marcorispoli/PCB304/README.md

CHANGE LOG

________________________________________________________________________
01/07/2025 - Release 2 - 
Aggiornata serigrafia J11 (era rovesciata)
________________________________________________________________________
