marcorispoli/PCB304/(list of files, cad)

Other CAD files:
ESECUTIVI/PM22-304-2.dwg
LAYOUT/22-304-2.dwg
ESECUTIVI/22-304-2.dwg
ESECUTIVI/PF22-304-2.dwg
