marcorispoli/PCB304/ORCAD/SE22-304-2.pdf

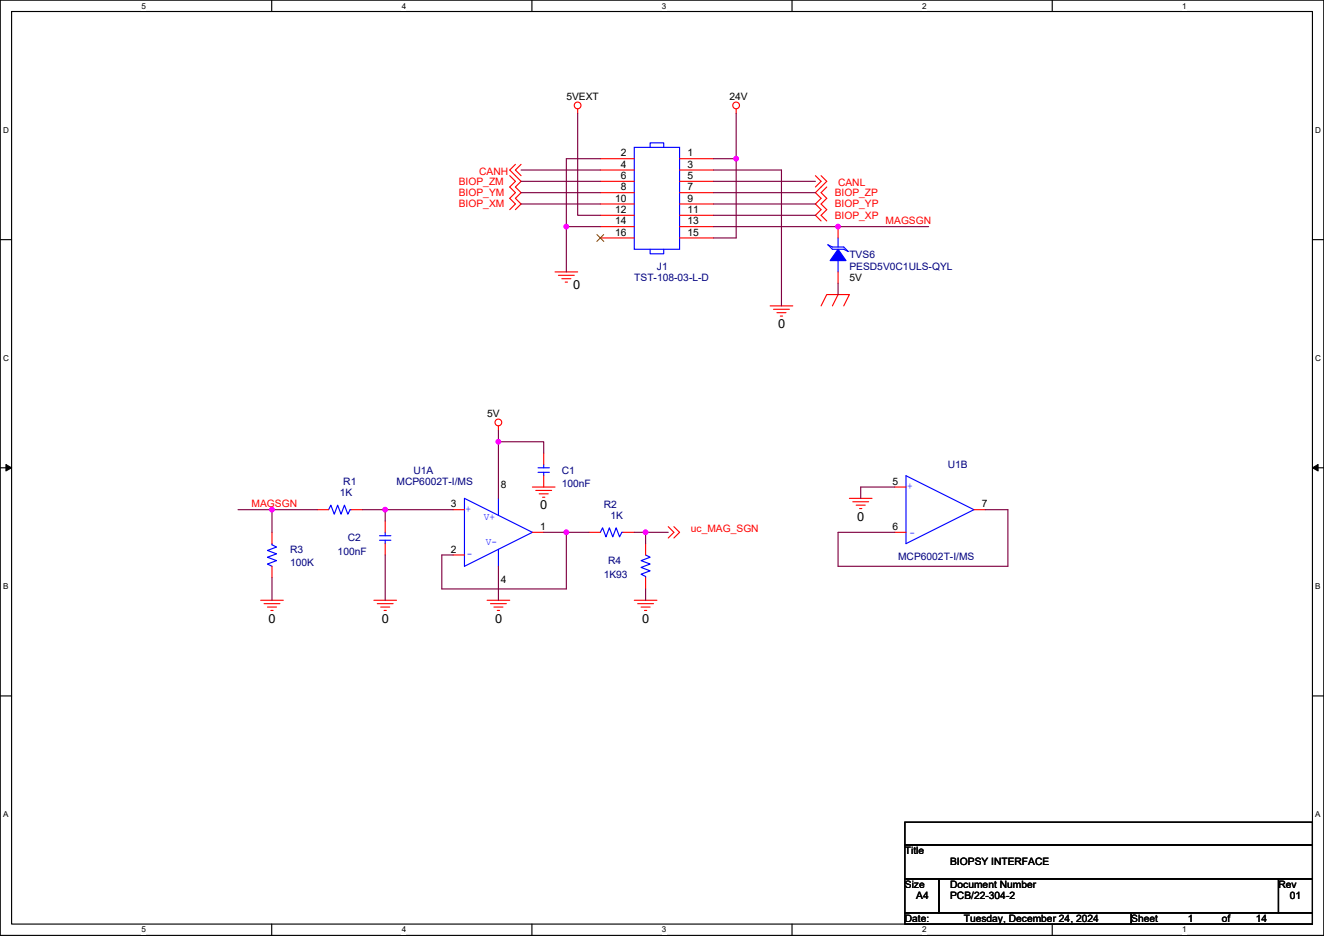
[picture p1: page 1]

Size A4 | Document Number PCB/22-304-2 | Rev 01

Date: Tuesday, December 24, 2024 Tuesday, December 24, 2024 Tuesday, December 24, 2024 | Sheet 1 1 1 of 14 14 14

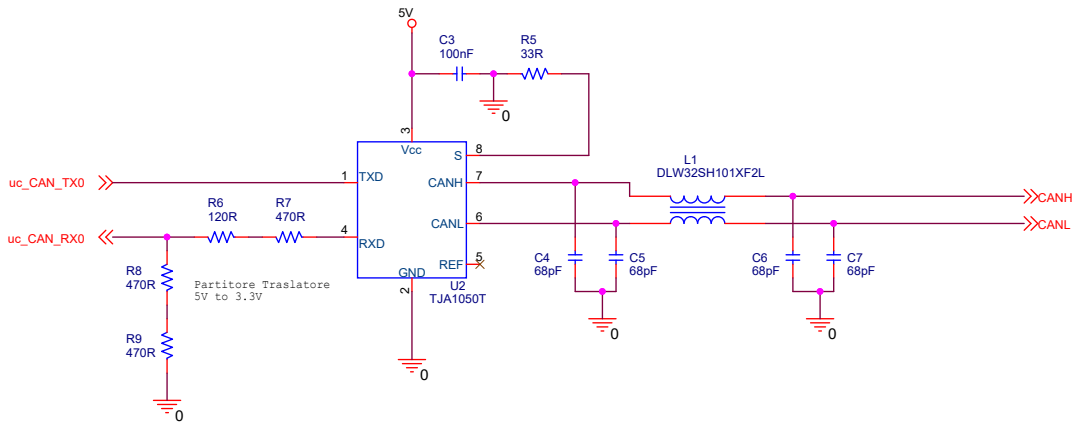
[picture p2: page 2]

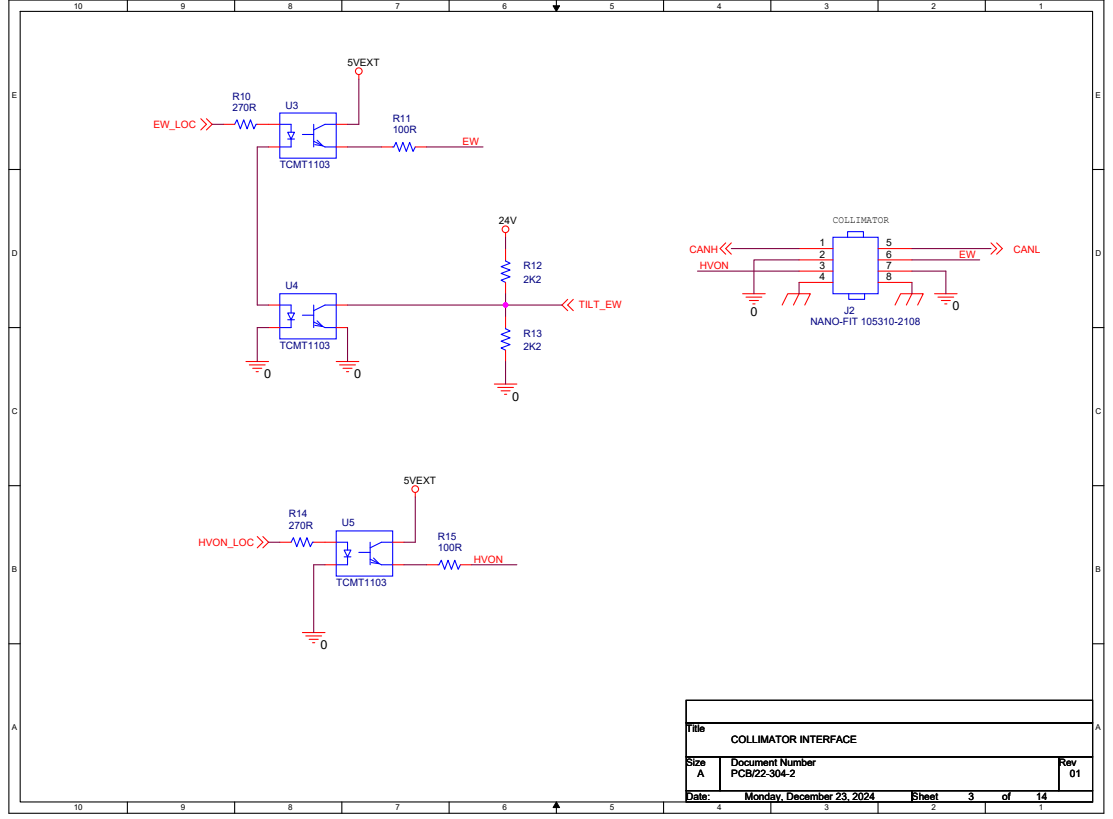
[picture p3: page 3]

Monday, December 23, 2024 Monday, December 23, 2024 Monday, December 23, 2024 | 3 3 3 14 14 14

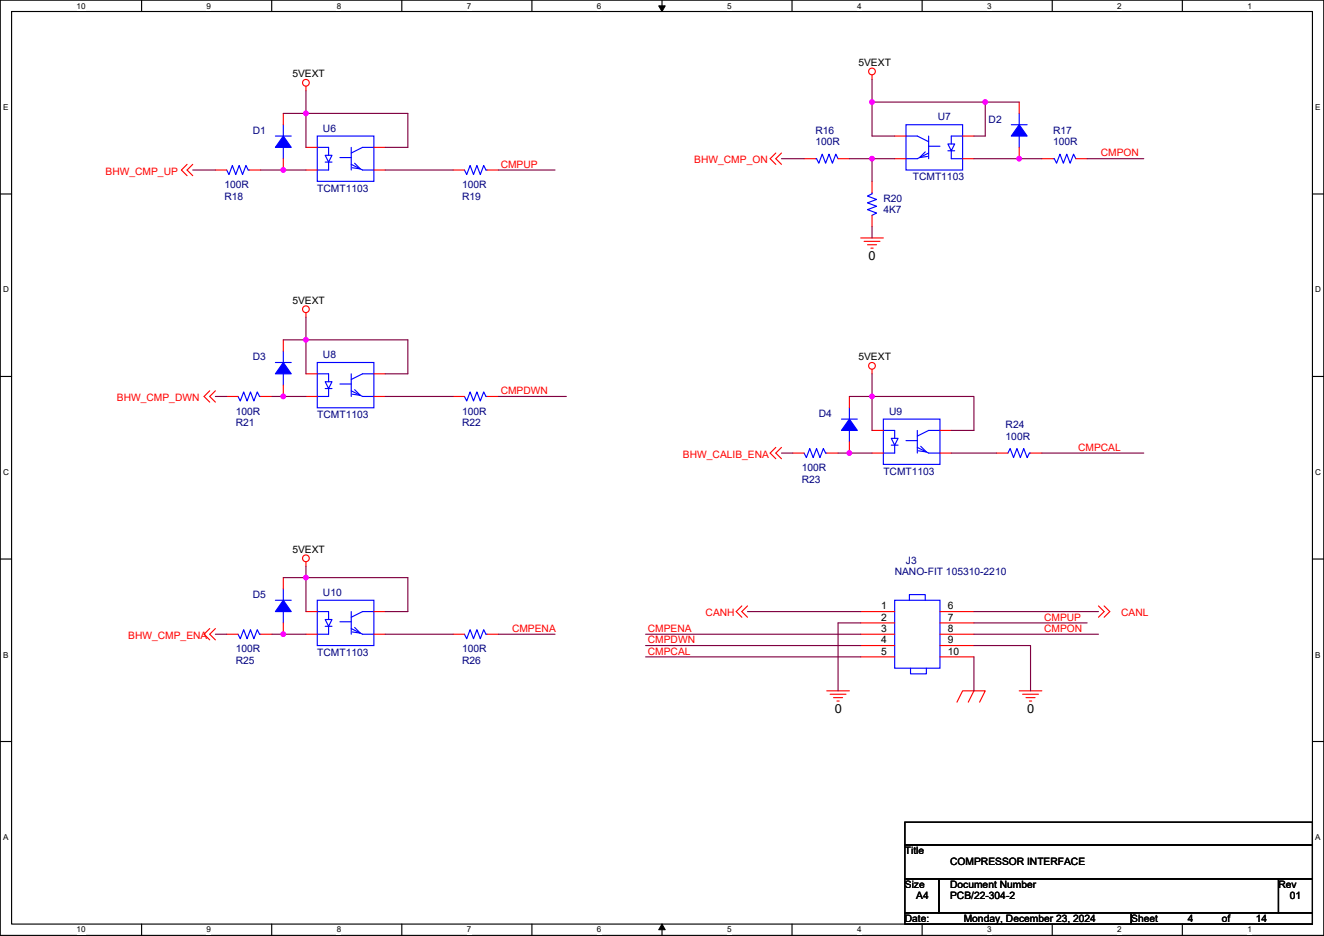
[picture p4: page 4]

0

0

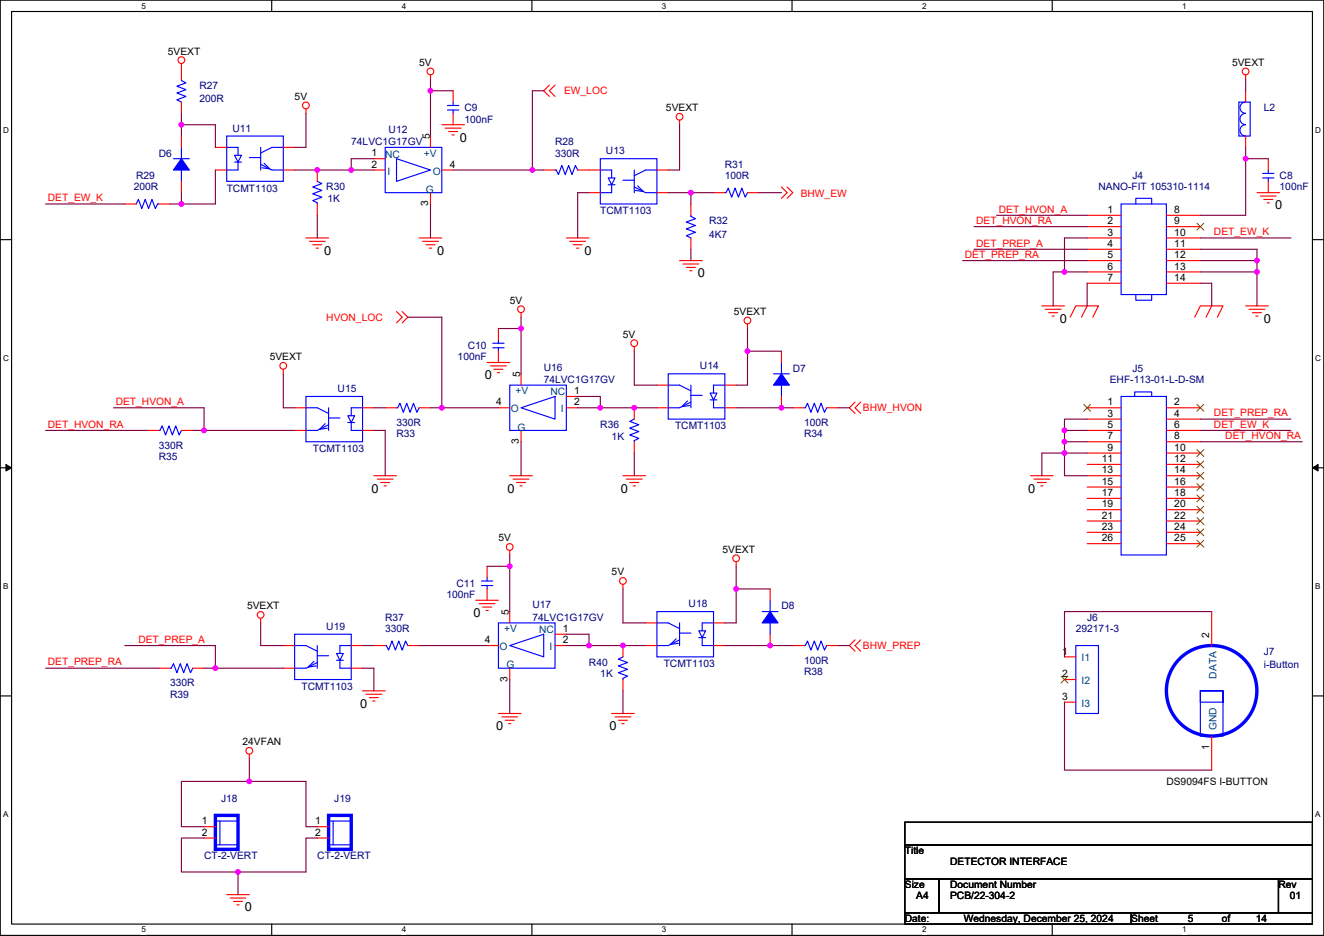
[picture p5: page 5]

0

0

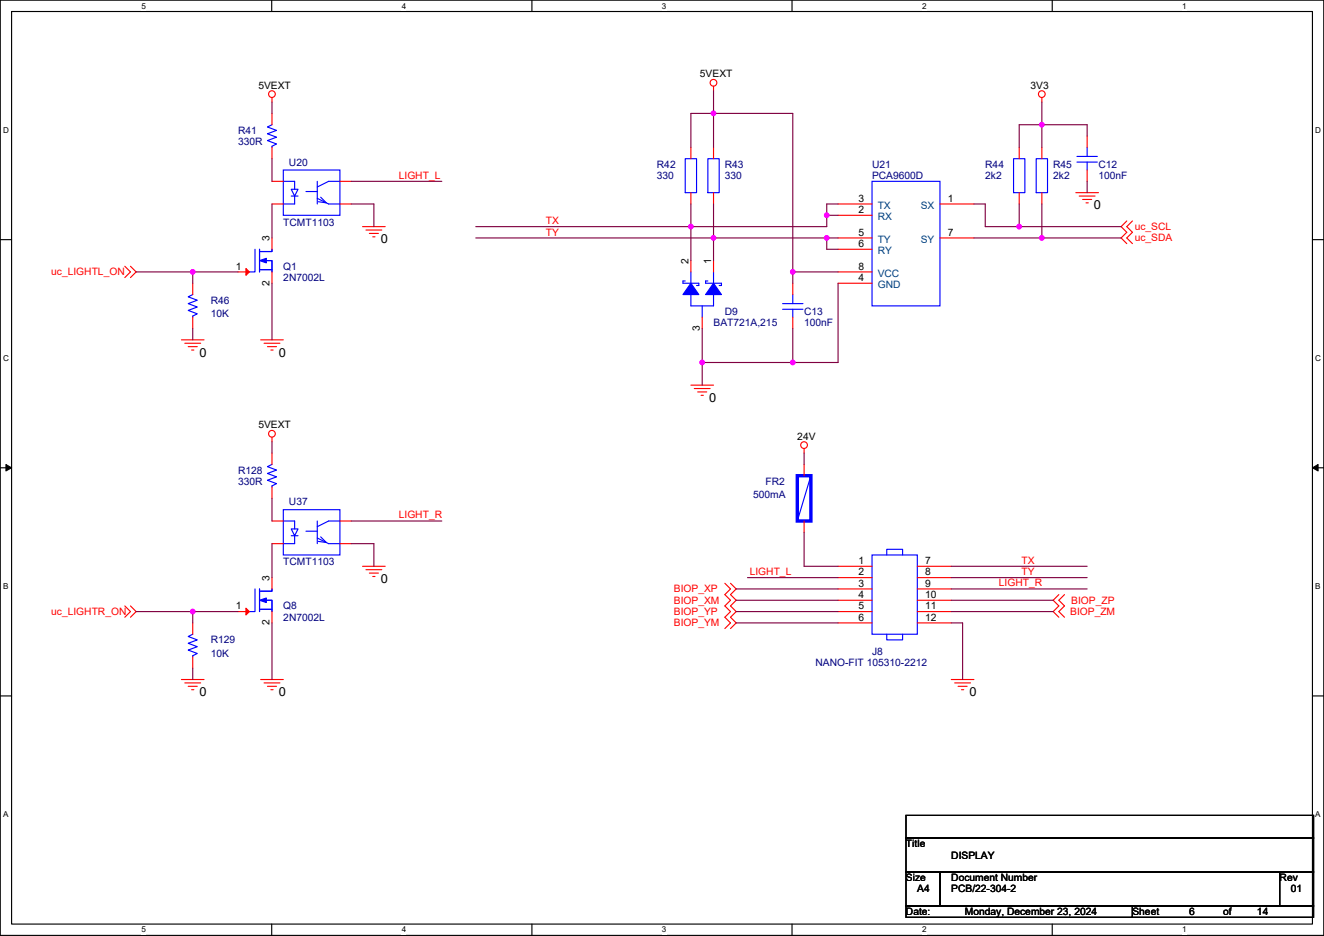
[picture p6: page 6]

0

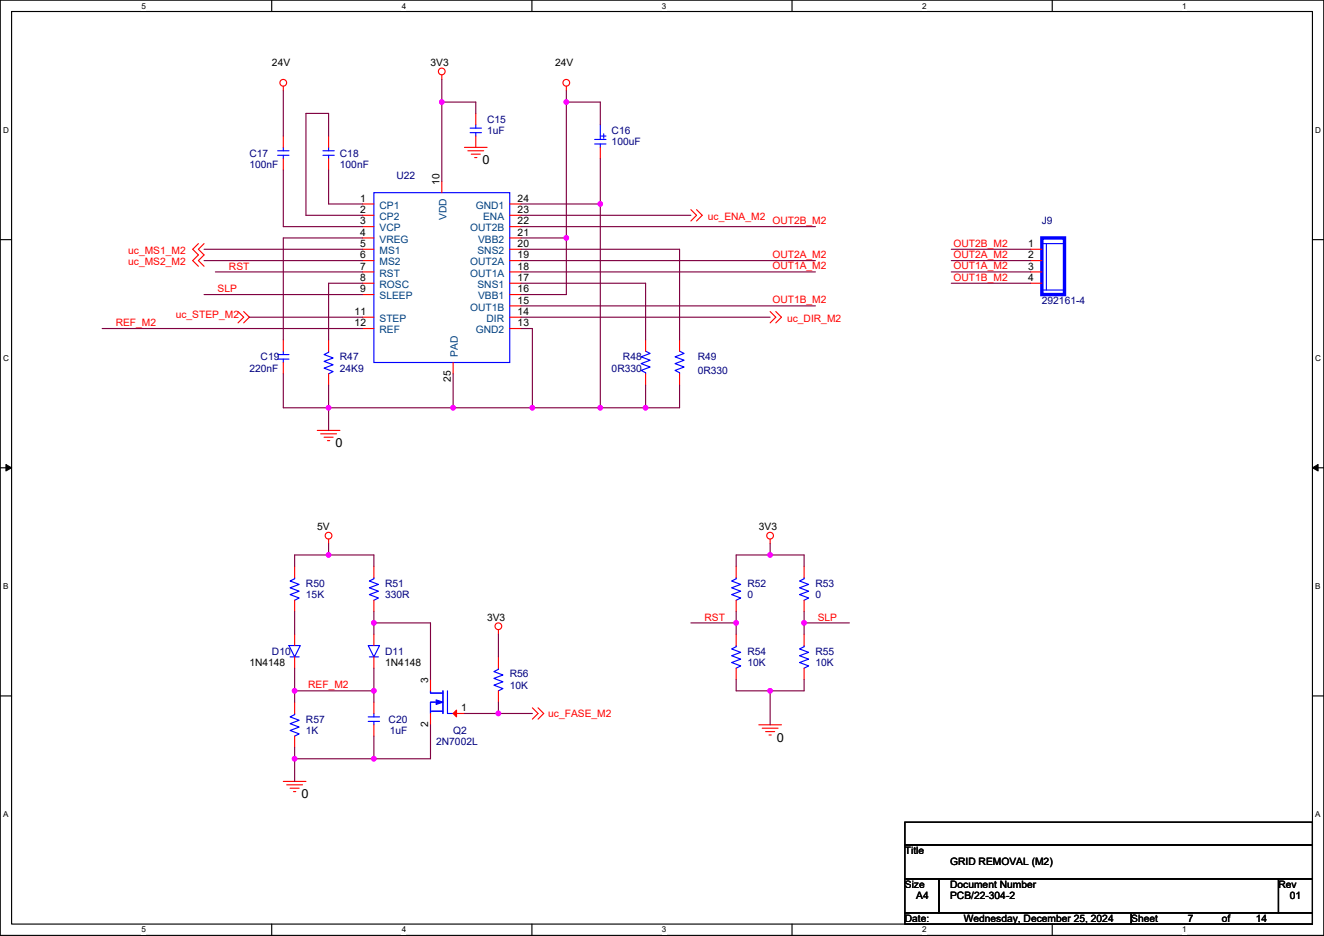
[picture p7: page 7]

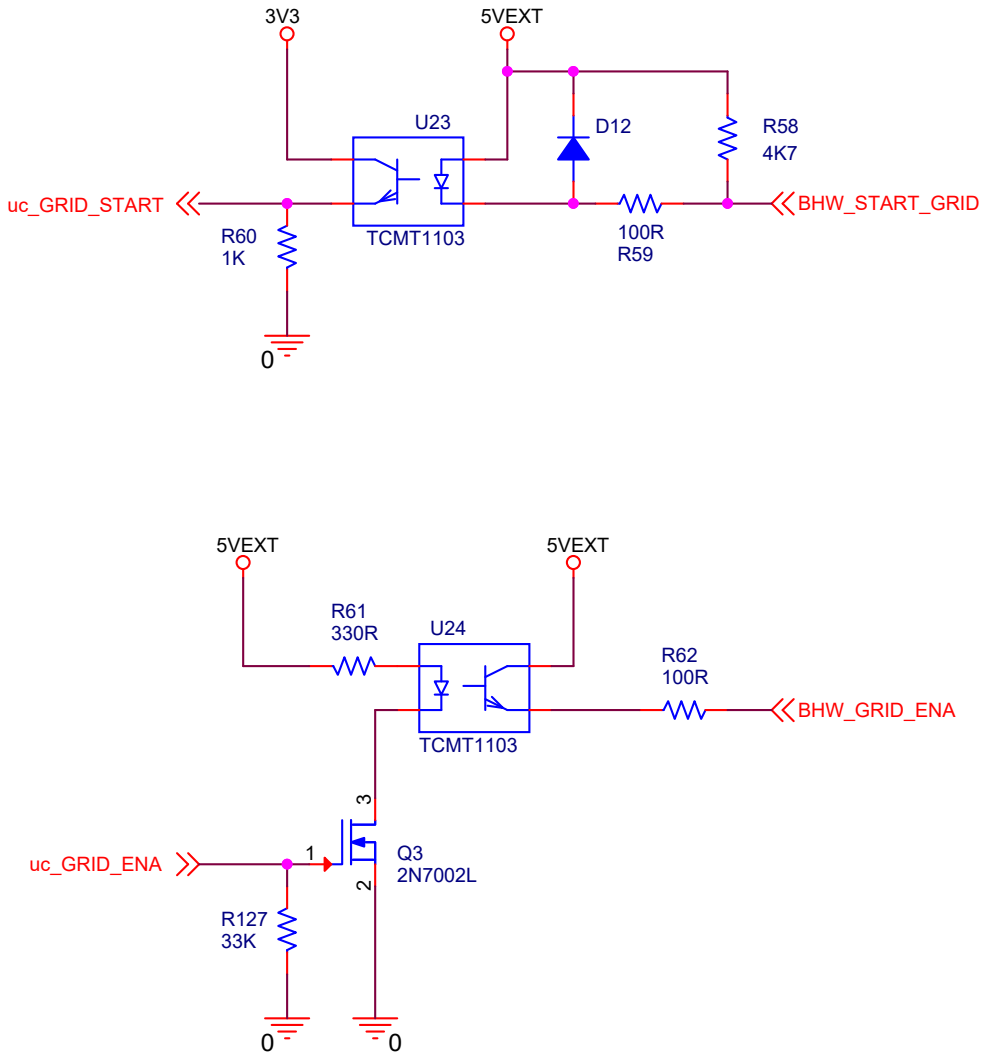
[picture p8: page 8]

Monday, December 23, 2024 Monday, December 23, 2024 Monday, December 23, 2024 | 8 8 8 14 14 14

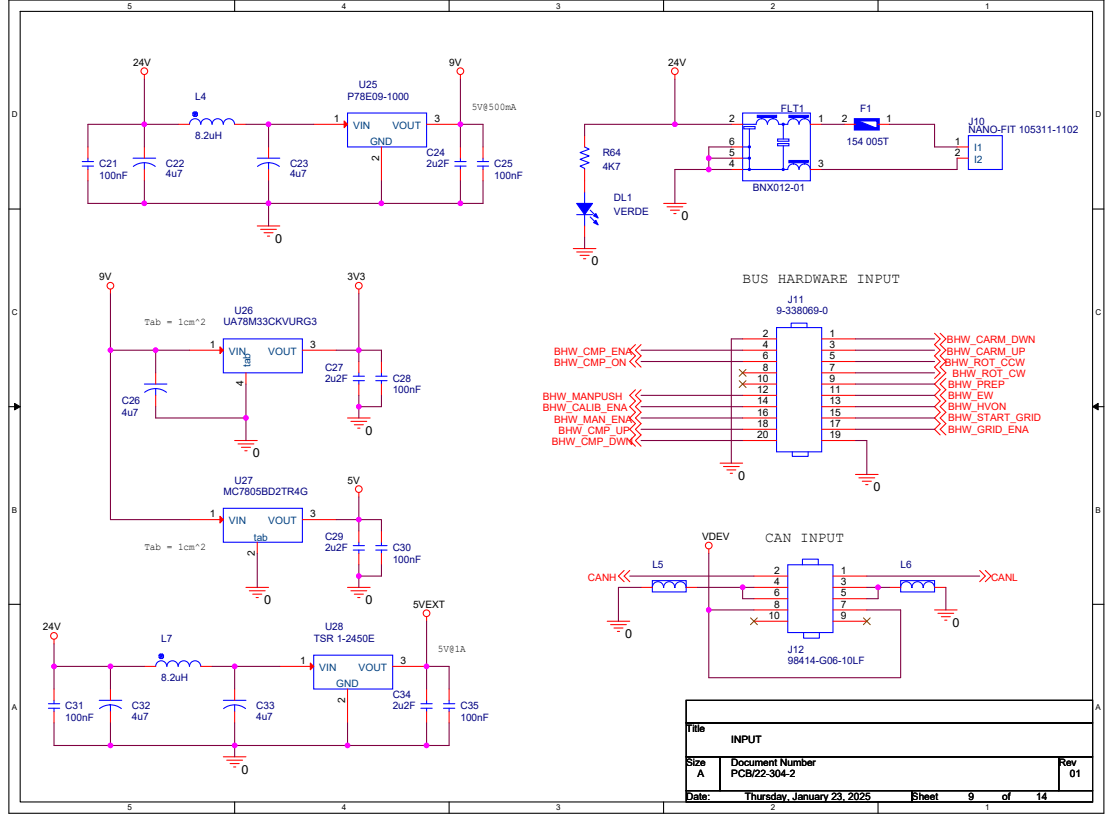
[picture p9: page 9]

Thursday, January 23, 2025 Thursday, January 23, 2025 Thursday, January 23, 2025 | 9 9 9 14 14 14

0

0

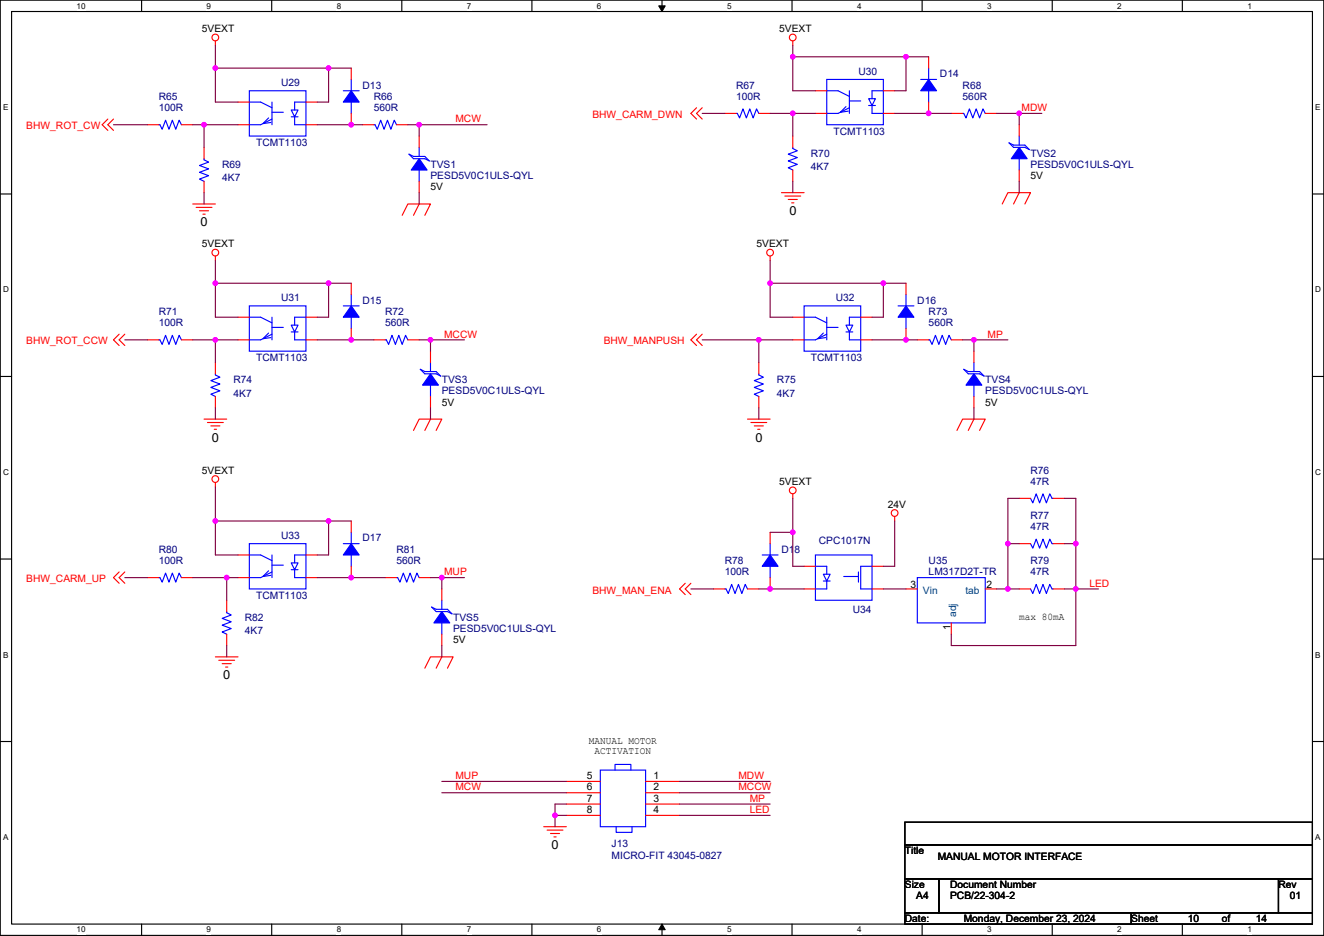
[picture p10: page 10]

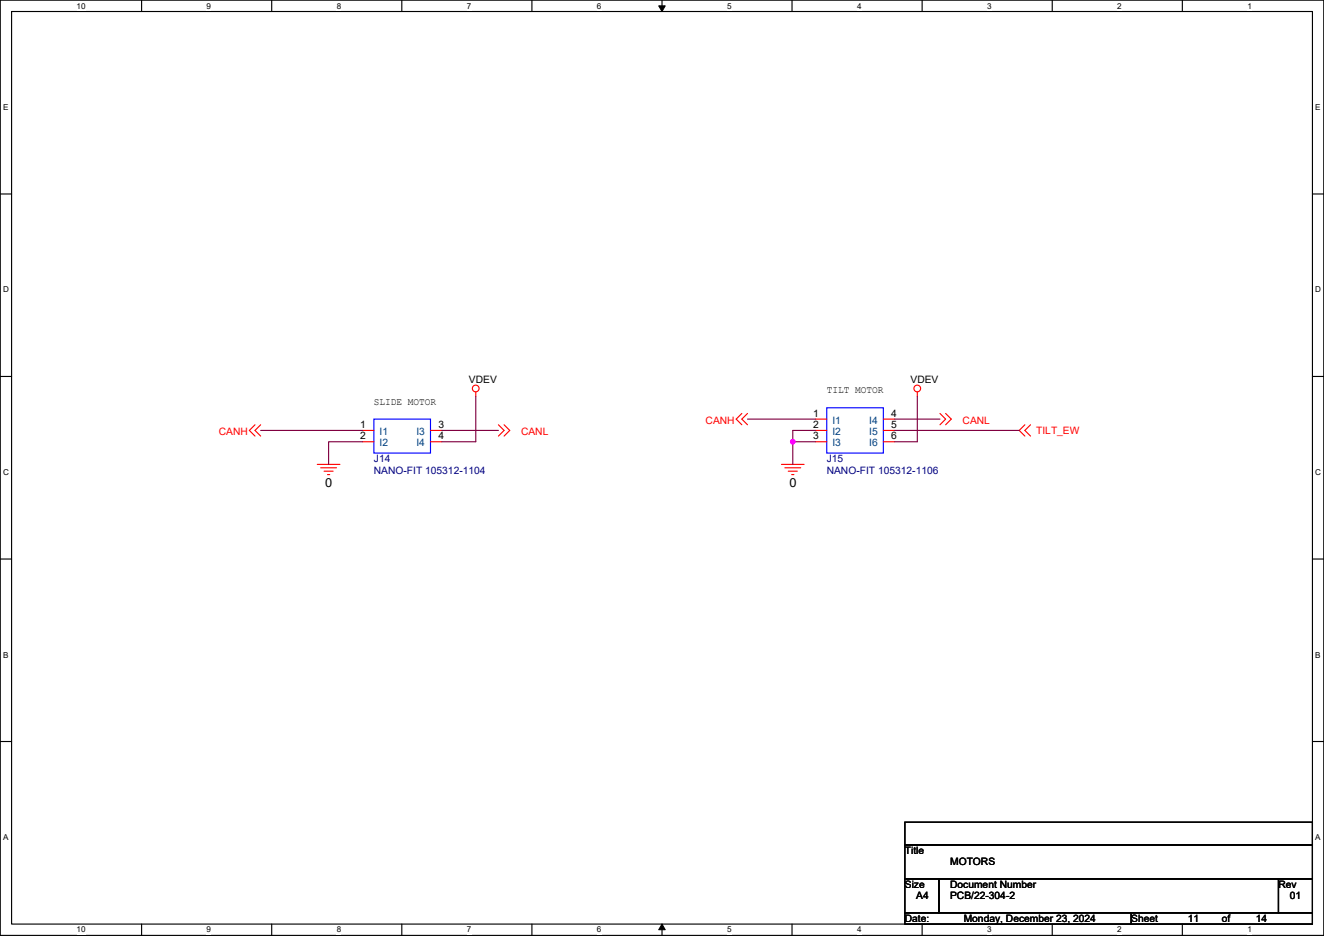
[picture p11: page 11]
TILT MOTOR; SLIDE MOTOR; VDEV; CANH; CANL; TILT_EW; Title; MOTORS; Monday, December 23, 2024; J15 NANO-FIT 105312-1106; J14 NANO-FIT 105312-1104

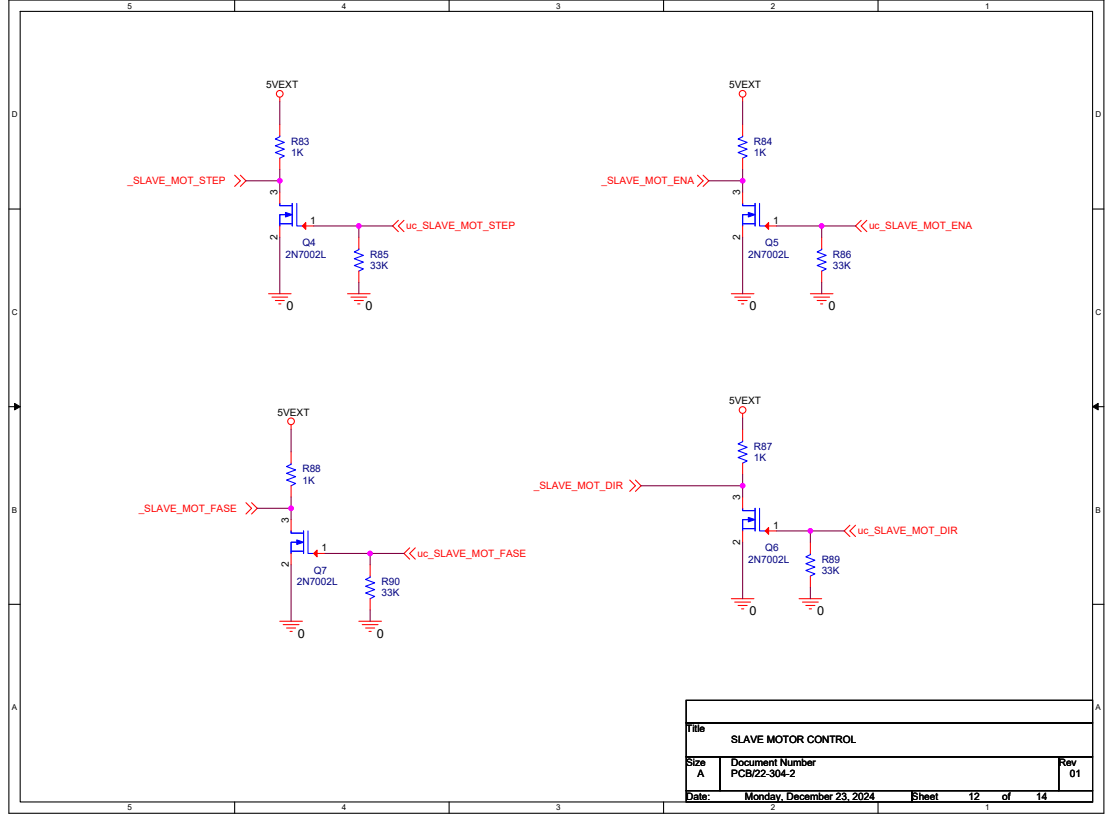
[picture p12: page 12]

Monday, December 23, 2024 Monday, December 23, 2024 Monday, December 23, 2024 | 12 12 12 14 14 14

0 | 0

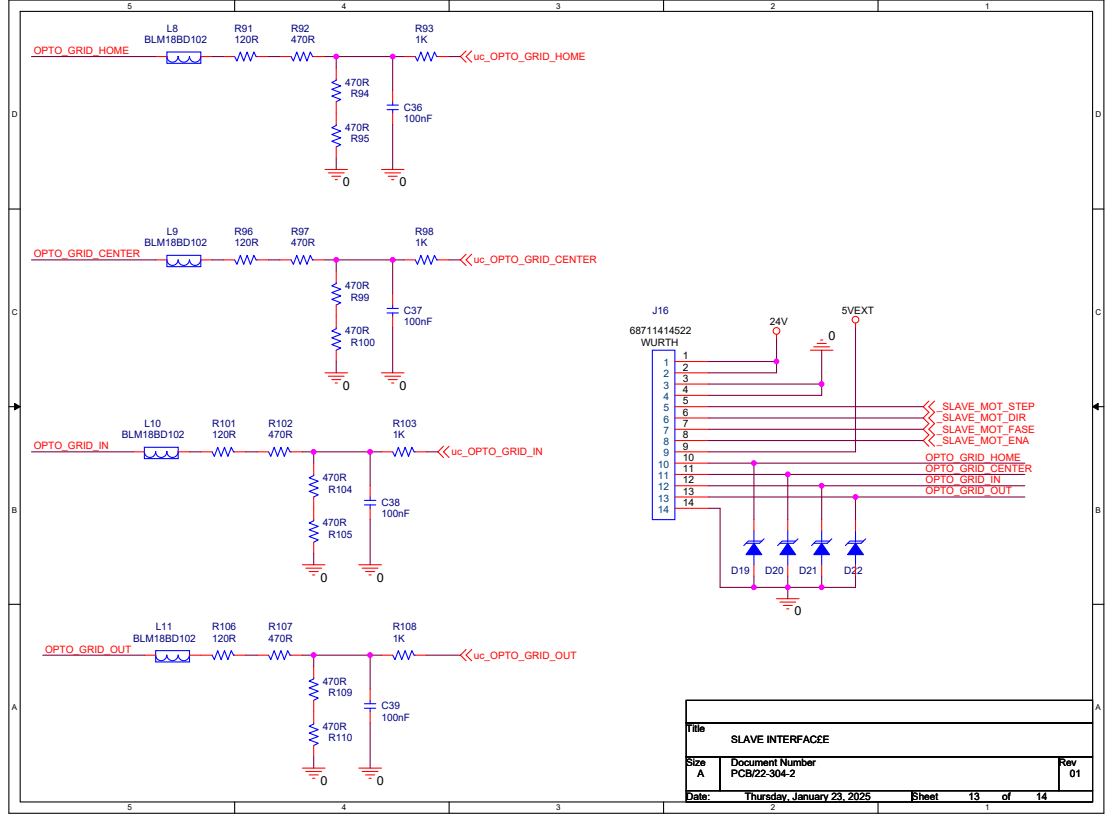
[picture p13: page 13]

Thursday, January 23, 2025 Thursday, January 23, 2025 Thursday, January 23, 2025 | 13 13 13 14 14 14

0 | 0

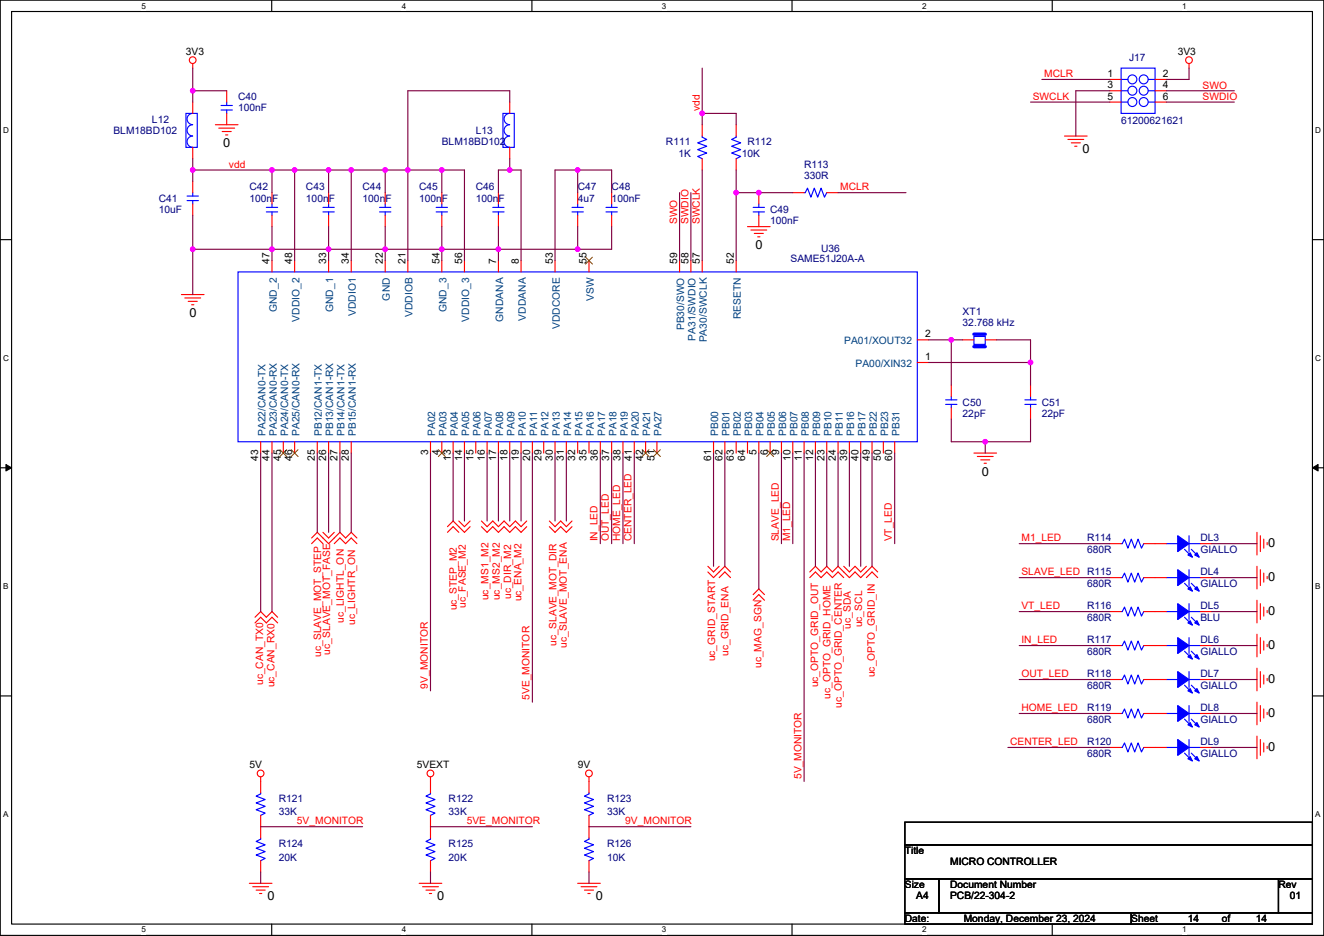
[picture p14: page 14]
