marcorispoli/PCB304/ESECUTIVI/PM22-304-2.pdf

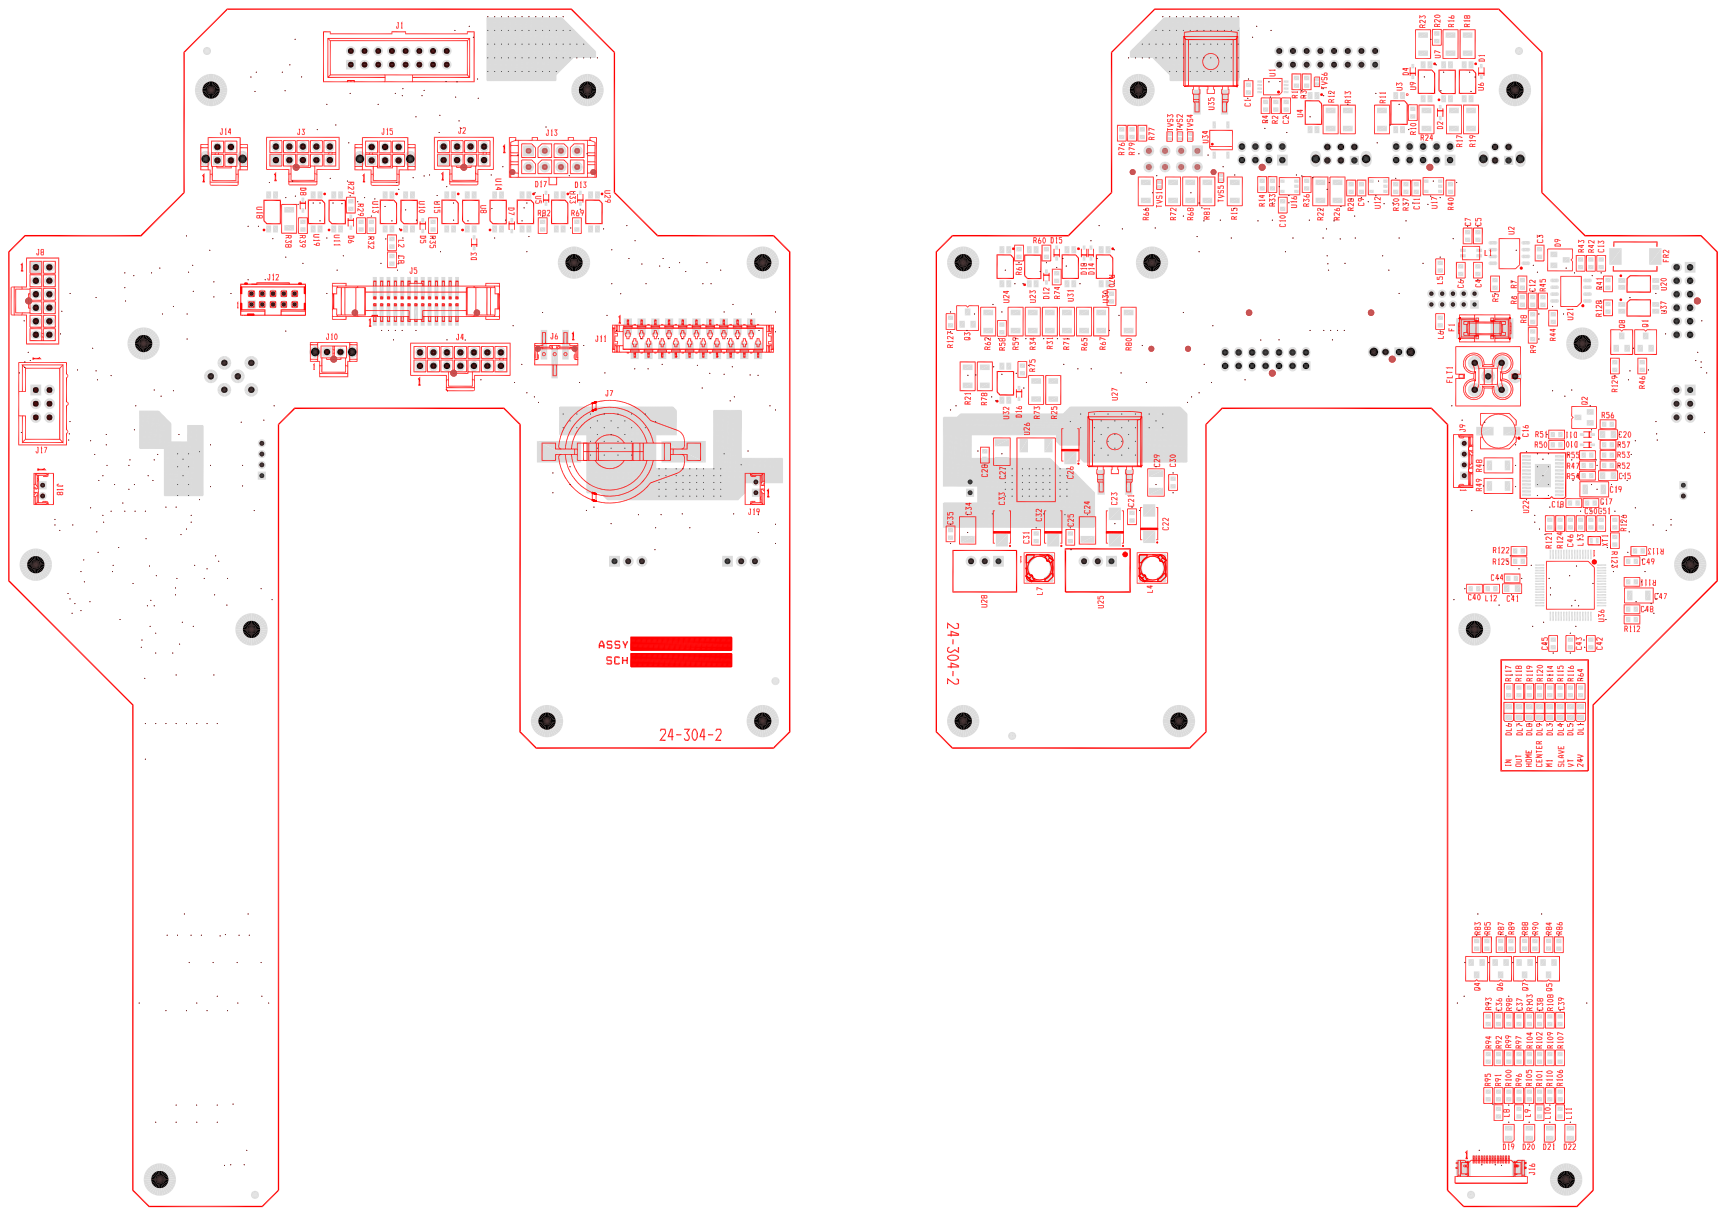
[picture p15: page 1]
