marcorispoli/PCB304/ESECUTIVI/Gerber 22-304-2/PF22-304-2.pdf

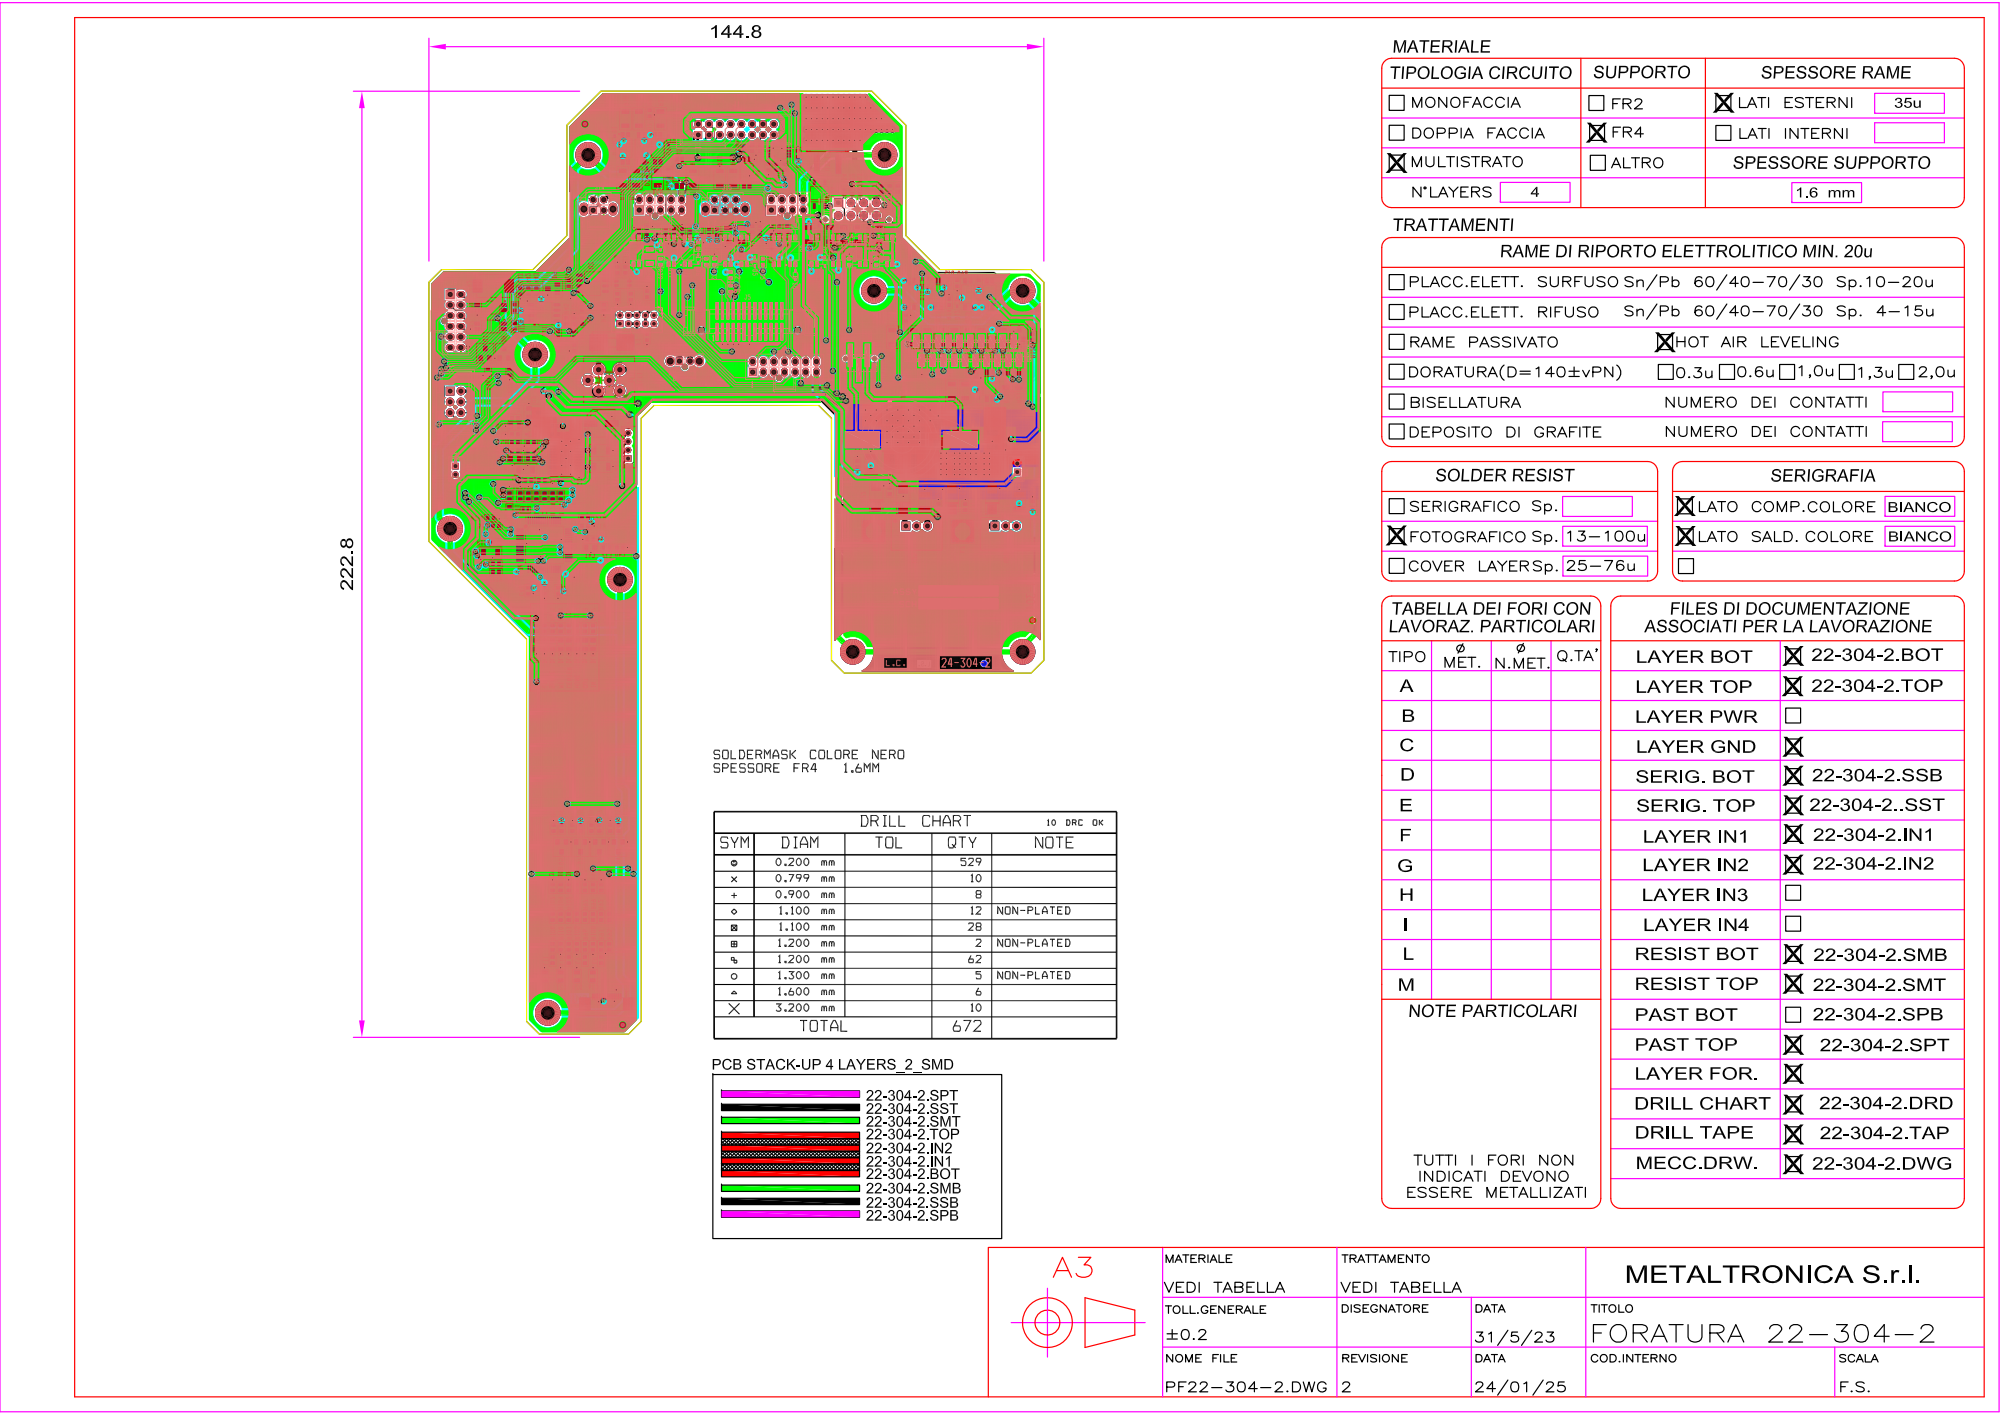
[picture p16: page 1]
