marcorispoli/PCB304/(list of files, drawings)

Other design files:
ORCAD/22-304-2.DSN
ORCAD/22-304-2.opj
