marcorispoli/PCB304/(commit log)

2023-04-11 Project initialization
    [22-304-0.DSN, 22-304-0.opj]
2023-04-20 Aggiunta sezione per il controllo del display Modificato il controllo dei motori con pilotaggio diretto del micro controllate nets
    [22-304-0.DSN, 22-304-0.opj]
2023-05-05 Aggiornato connettori Versiote inviata per lo sbroglio
    [22-304-0.DSN, 22-304-0.opj]
2023-05-09 Aggiunto files per il primo piazzamento
    [22-304-0.DSN, 22-304-0.dxf, 22-304-0.opj, 22-304-0.pcb]
2023-06-06 Esecutivi consegnati da Osvaldo e inviati a Soldà per prototipazione
    [22-304-0.DSN, 22-304-0.dwg, 22-304-0.dxf, 22-304-0.opj, 22-304-0.pcb, LP22-304-0.xlsx, PF22-304-0.dwg, PM22-304-0.dwg]
2024-04-11 Aggiornato con modifiche Lanfranco
    [22-304-0.DSN, 22-304-0.opj]
2024-04-17 Modificato connettori con utilizzo dei Molex Nanofit
    [22-304-0.DSN, 22-304-0.opj, PCB-22-304.DSN, PCB-22-304.opj]
2024-04-18 Applicato le modifiche per andare a release 1: attesa sbroglio
    [22-304-0.dwg, LP22-304-0.xlsx, PCB-22-304-1 - GRID CONTROLL POTTER (1).DXF, PCB-22-304.DSN, PCB-22-304.opj, PF22-304-0.dwg, PM22-304-0.dwg]
2024-05-07 Sbroglio Osvaldo
    [22-304-1.DSN, 22-304-1.dwg, 22-304-1.opj, LP22-304-1.xlsx, PCB-22-304-1 - GRID CONTROLL POTTER (1).DXF, PCB-22-304.DSN, PCB-22-304.opj, PF22-304-1.dwg]
2024-05-09 Corretto lista parti sul componente DC/DC 9V
    [22-304-1.DSN, 22-304-1.opj, LP22-304-1.xlsx]
2024-12-06 Inizio release 2
    [22-304-1.DSN, 22-304-1.opj, 22-304-2.DSN, 22-304-2.opj]
2024-12-09 Aggiunto pagine Detector e biopsia
    [22-304-2.DSN, 22-304-2.opj]
2024-12-17 Completato trasferimento da PCB305 a 304
    [22-304-2.DSN, 22-304-2.opj]
2024-12-20 Pronto per lo sbroglio
    [22-304-2.DSN, 22-304-2.opj]
2024-12-23 Modificato alimentazione Display e layout connettore Unificato masse e 24V net
    [22-304-2.DSN, 22-304-2.opj]
2025-01-27 PROGETTO COMPLETO DI ESECUTIVI
    [22-304-1.dwg, 22-304-2.DSN, 22-304-2.dwg, 22-304-2.opj, LP22-304-1.xlsx, LP22-304-2.xlsx, PF22-304-1.dwg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]
2025-06-10 Riorganizzati i segnali dei sensori ottici.
    - Scambiati i segnali OPTO_GRID_HOME e OPTO_GRID_IN.
    - Scambiati i segnali OPTO_GRID_CENTER e OPTO_GRID_OUT.
    - Scambiati i segnali uc_OPTO_GRID_HOME e uc_OPTO_GRID_IN.
    - Scambiati i segnali uc_OPTO_GRID_CENTER e uc_OPTO_GRID_OUT.
    - Rinominato il segnale OPTO_GRID_IN in OPTO_GRID_FIELD.
    - Rinominato il segnale OPTO_GRID_OUT in OPTO_GRID_ZERO.
    - Rinominato il segnale uc_OPTO_GRID_IN in uc_OPTO_GRID_FIELD.
    - Rinominato il segnale uc_OPTO_GRID_OUT in uc_OPTO_GRID_ZERO.
    - Rinominato il segnale IN_LED in FIELD_LED.
    - Rinominato il segnale OUT_LED in ZERO_LED.
    [22-304-2.DSN, 22-304-2.opj]
2025-07-01 Aggiornato Serigrafia J11 che risultava girata
    [22-304-2.DSN, 22-304-2.dwg, 22-304-2.opj, PM22-304-2.dwg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]
2026-01-15 Aggiornata lista parti a rev01
    [LP22-304-2.xlsx, LP22-304-2_rv01.xlsx]
